linuxxon/wifi-seeker/hemsida/plan3.png

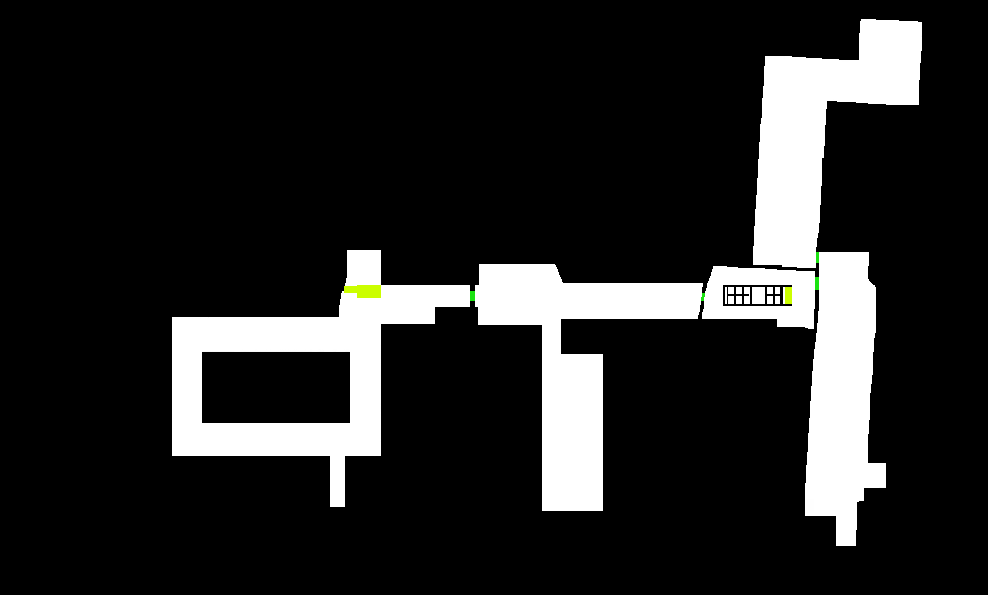
hemsida/plan3.png
