linuxxon/wifi-seeker/hemsida/plan3_norr.png

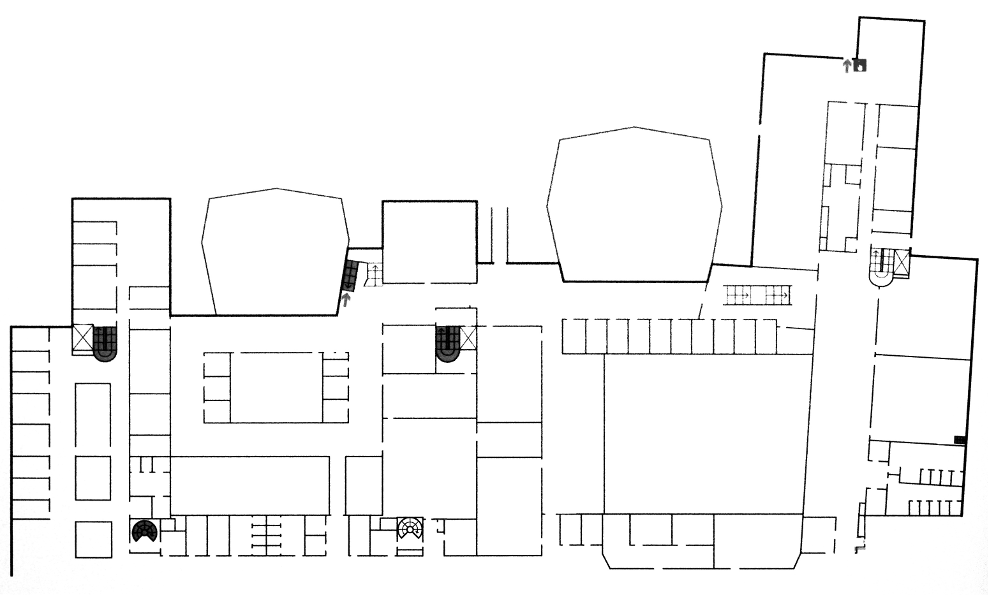
hemsida/plan3_norr.png
