linuxxon/wifi-seeker/(commit log)

2015-04-21 Lade till dokumentation för kommunikation mellan robot och arduino
2015-04-22 Create pwm
2015-04-22 kod för pwm-styrning (delvis)
2015-04-24 add arduino-main
2015-05-06 Switched to png
2015-05-07 Added intent to web button
2015-05-07 Web button scans as intended, adding coordinates to scan results
2015-05-07 Added table for buttons and all buttons are build from <a> tags.
2015-05-08 Added modes with physical switch
2015-05-08 Added Clear Result and Refresh button
2015-05-11 Refresh button fixed
2015-05-11 Check for arduino now on startup
2015-05-13 update arduino
